Sixaxis9/GiordyBot_Electronics/Wiki_Img/Communication.PNG

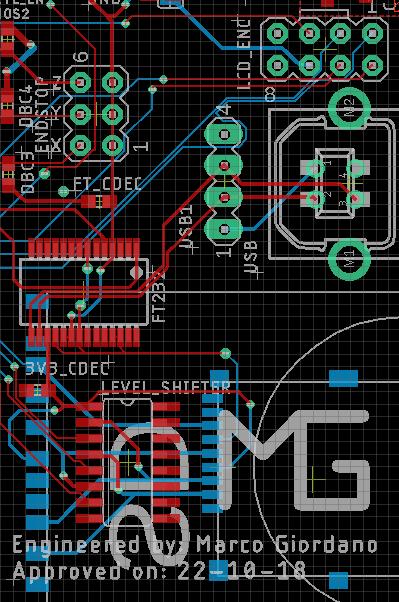
Wiki_Img/Communication.PNG
