Sixaxis9/GiordyBot_Electronics/Wiki_Img/Driver_IC.PNG

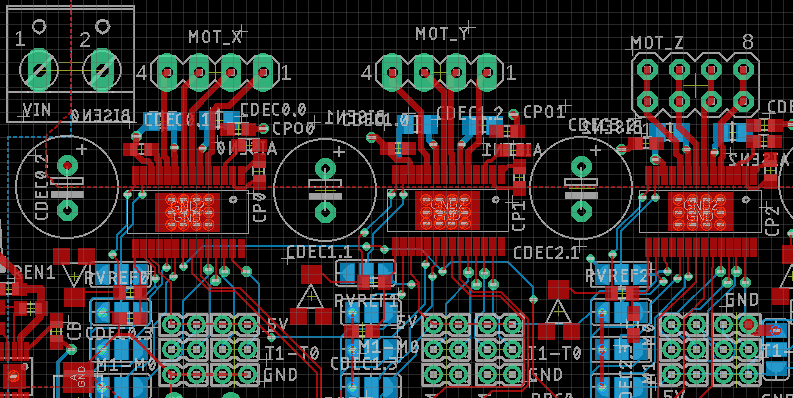
Wiki_Img/Driver_IC.PNG
