Sixaxis9/GiordyBot_Electronics/Wiki_Img/MOS.PNG

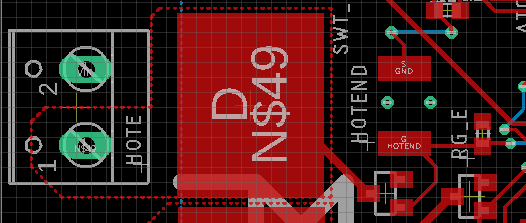
Wiki_Img/MOS.PNG
