Sixaxis9/GiordyBot_Electronics/Wiki_Img/PCB_Project.JPG

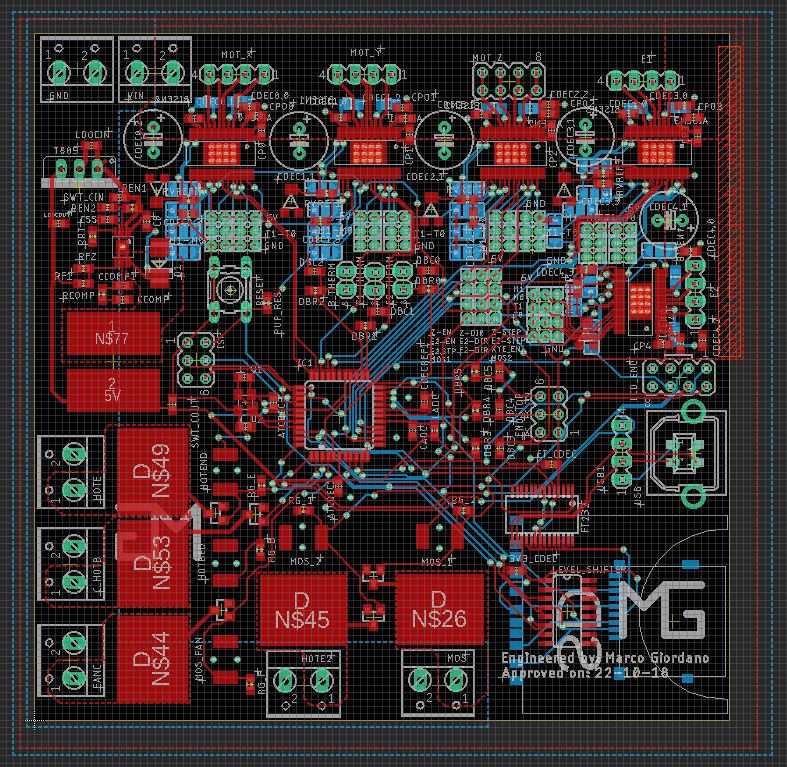
Wiki_Img/PCB_Project.JPG
