Sixaxis9/GiordyBot_Electronics/Wiki_Img/rsz_projects.jpg

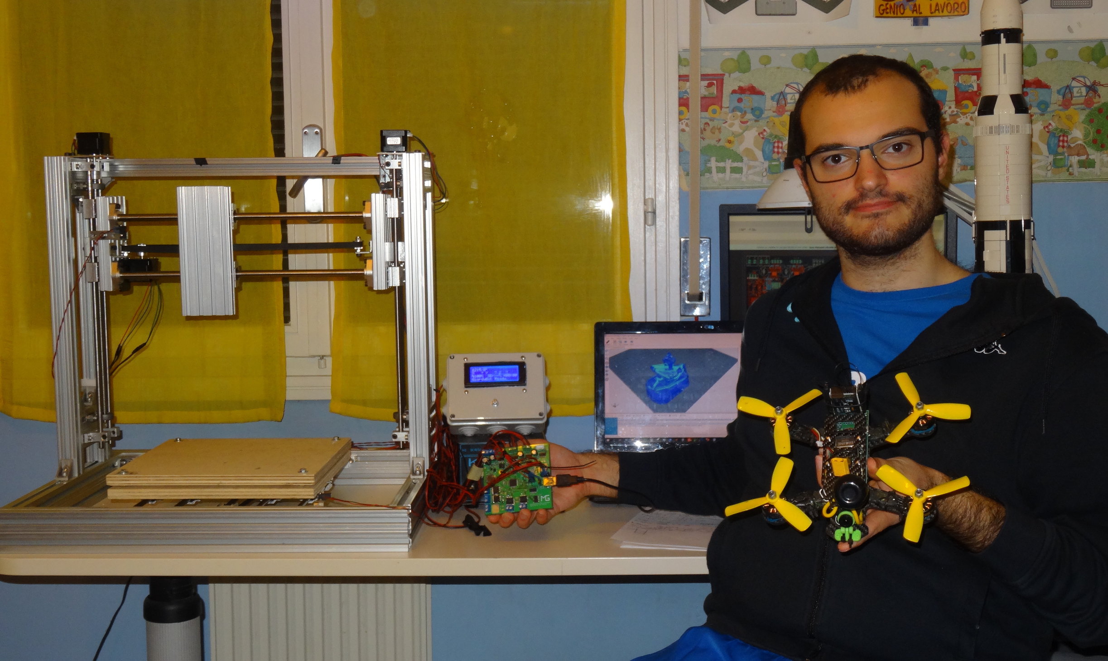
Wiki_Img/rsz_projects.jpg
