Sixaxis9/GiordyBot_Electronics/complete_schematic.pdf

# Y-DIR Y⁻STEP

# Y-STEP X⁻DIR

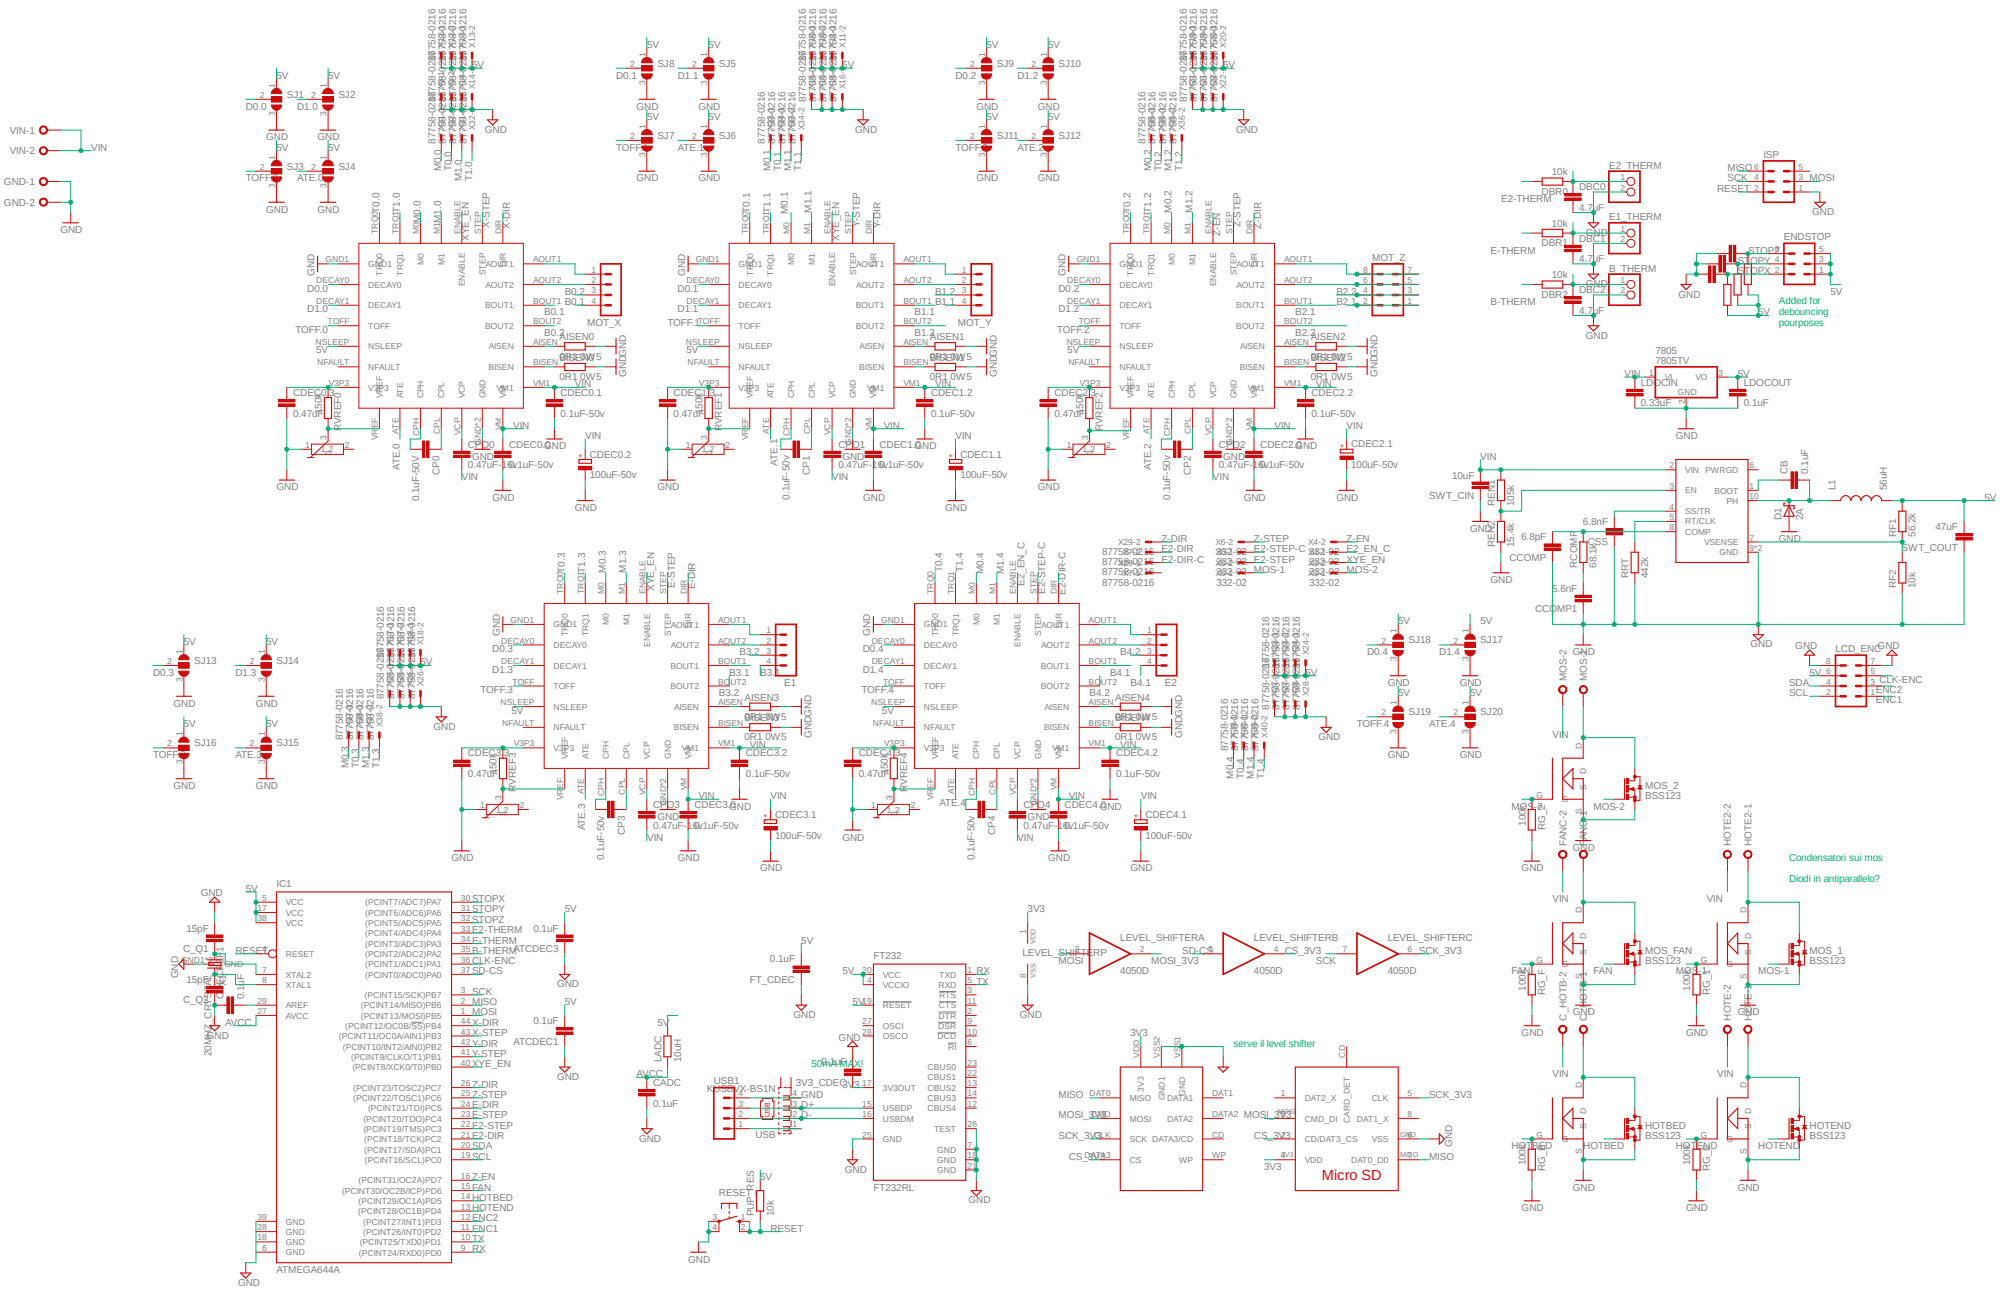
[picture p7: page 1]
KUSBVX-BS1N; GND; GND GND; 0R1 0W5 GND; GND ¹⁵⁰k; BSS123; GND ²⁰MHZ_CRYSTAL; 10k GND; GND 105k 15.4k; GND 100k 100k; ATMEGA644A; GND ⁰.1uF; GND1 GND1; DECAY0 DECAY0; DECAY1 DECAY1; TOFF TOFF; NSLEEP NSLEEP; NFAULT NFAULT; VREF VREF; ATE ATE; CPH CPH; CPL CPL; VCP VCP; GND GND*2; BISEN; AISEN; BOUT2; BOUT1; AOUT2; AOUT1; AOUT1 DIR DIR STEP STEP ENABLE ENABLE M¹ M¹ M⁰ M⁰ TRQ¹ TRQ¹ TRQ⁰ TRQ⁰; VCC 20; 3V3OUT 17; USBDP 15 USBDM 16; OSCO 28; OSCI 27; TXD; RXD; RTS; CTS; DTR; DSR; DCD; CBUS0; CBUS1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

Condensatori sui mos

Diodi in antiparallelo?

serve il level shifter

GND 18 | TX
GND 6 | RX
