Sixaxis9/GiordyBot_Electronics/CNC.brd

## EAGLE design CNC.brd (2019-01-07)

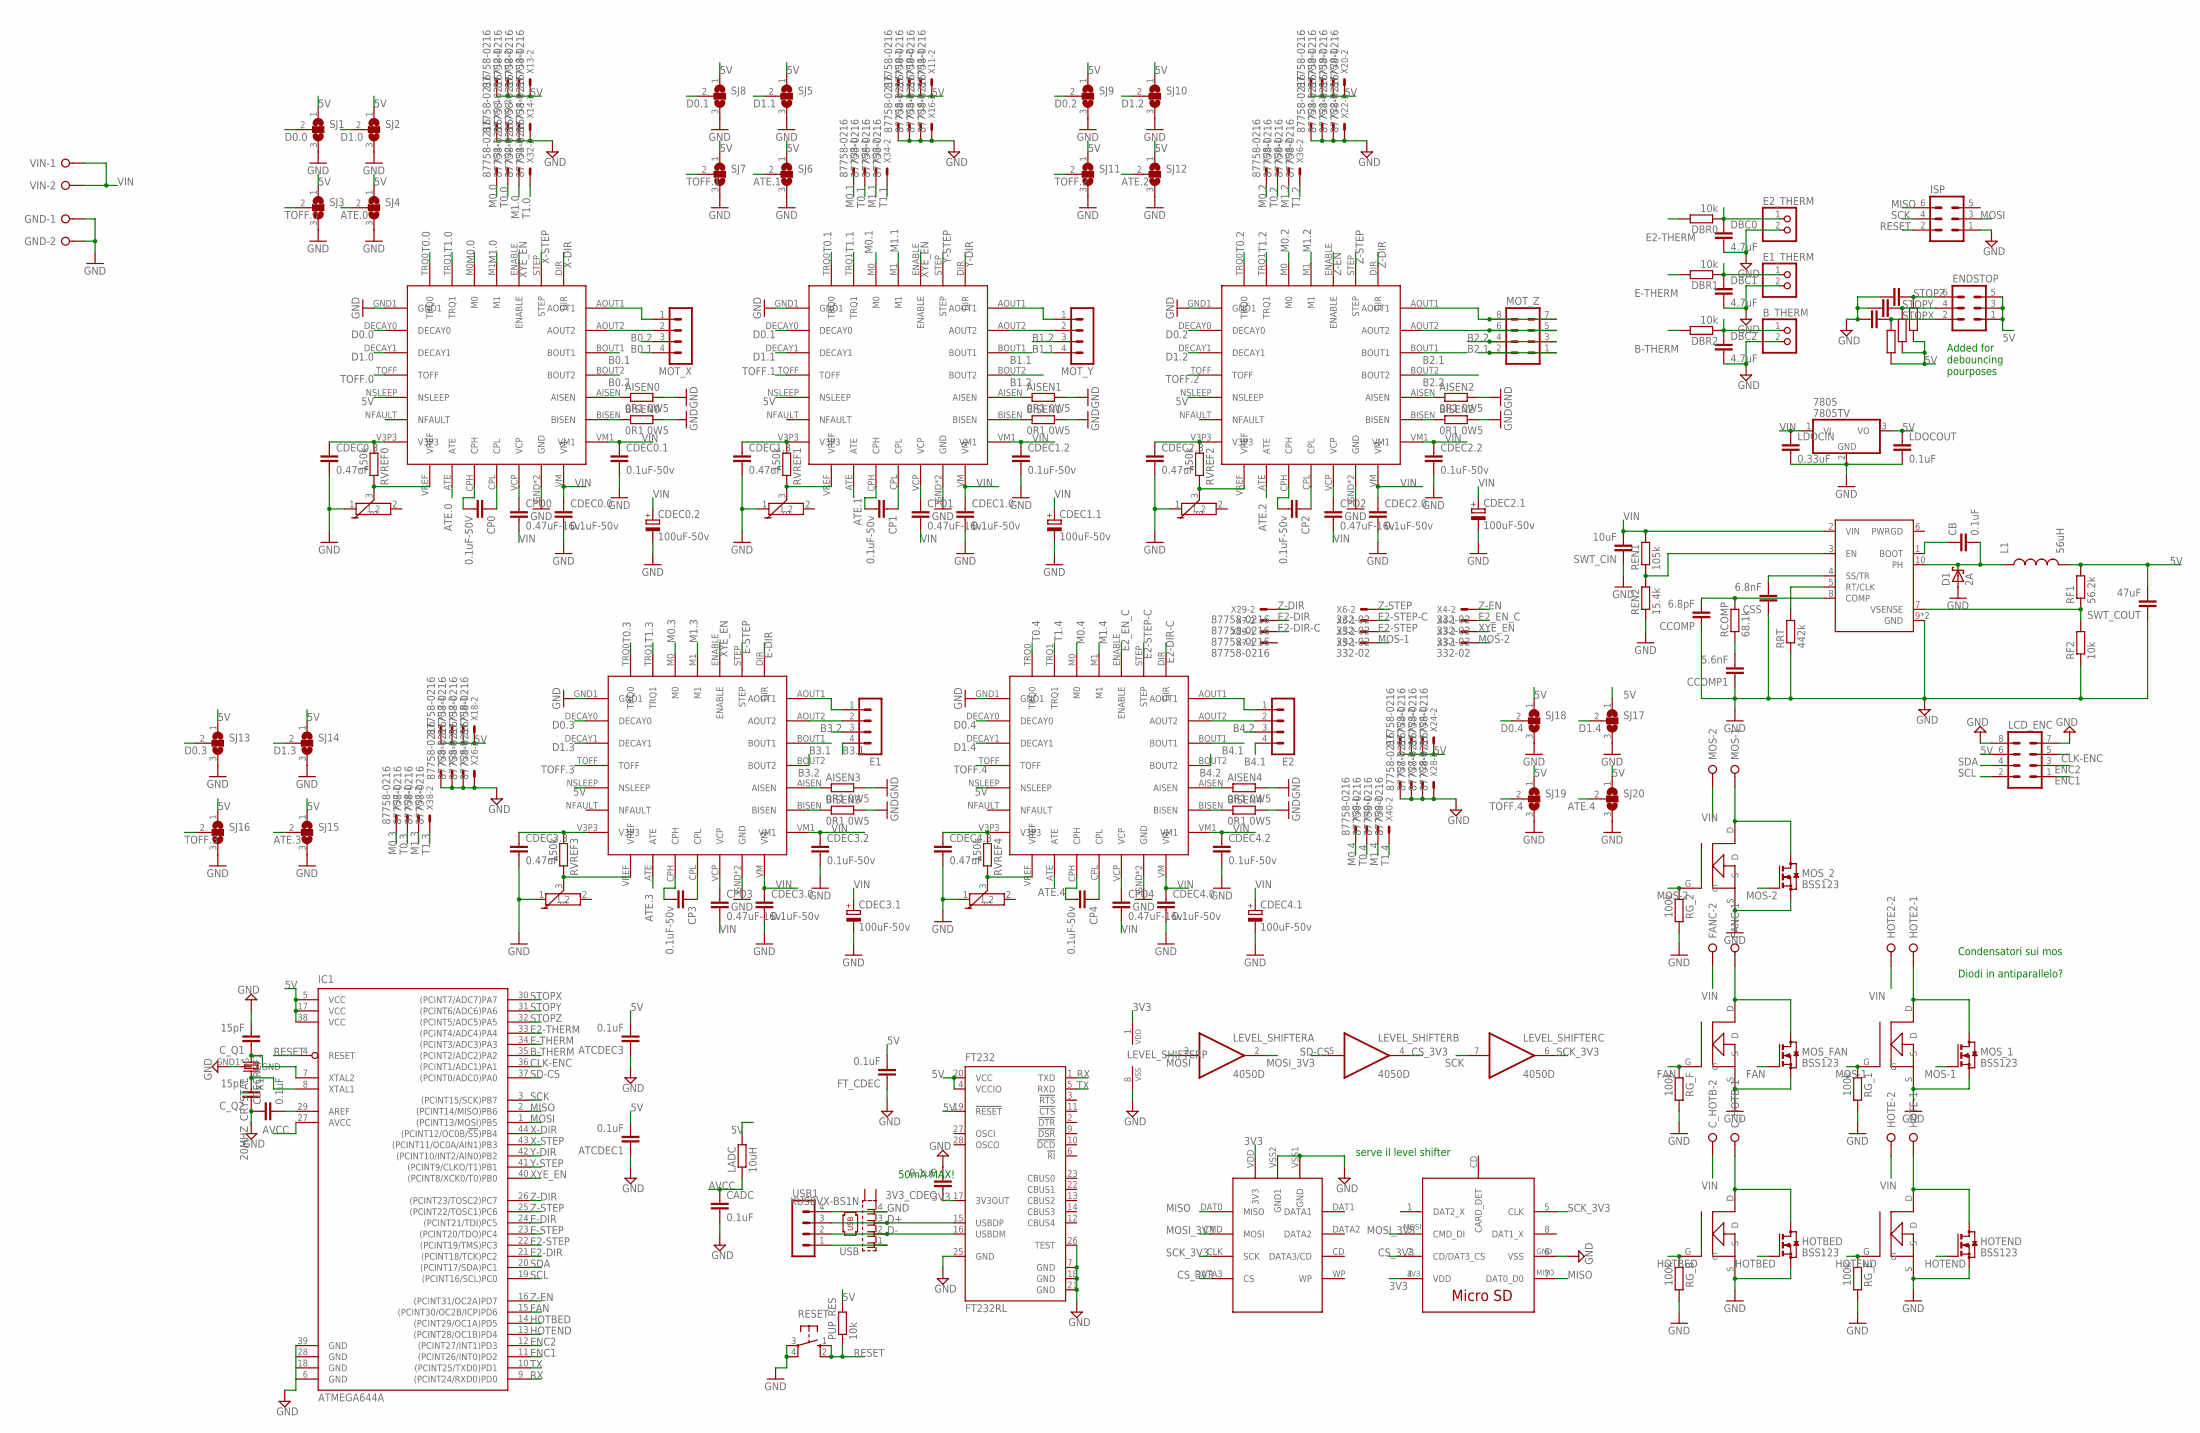
[picture p8: schematic CNC.sch]

Parts:
3V3_CDEC: 0.1uF; C0603
7805: 7805TV; TO220V
AISEN0, AISEN1, AISEN2, AISEN3, AISEN4: 0R1 0W5; R0805
ATCDEC1, ATCDEC3: 0.1uF; C0603
BISEN0, BISEN1, BISEN2, BISEN3, BISEN4: 0R1 0W5; R0805
B_THERM: PINHD-1X2; 1X02
CADC: 0.1uF; C0603
CB: 0.1uF; C0603
CCOMP: 6.8pF; C0603
CCOMP1: 5.6nF; C0603
CDEC0.0, CDEC0.1, CDEC1.0, CDEC1.2, CDEC2.0, CDEC2.2, CDEC3.0, CDEC3.2, CDEC4.0, CDEC4.2: 0.1uF-50v; C0603
CDEC0.2, CDEC1.1, CDEC2.1, CDEC3.1, CDEC4.1: 100uF-50v; E3,5-8
CDEC0.3, CDEC1.3, CDEC2.3, CDEC3.3, CDEC4.3: 0.47uF; C0603
CDECREF1: 0.1uF; C0603
CP0: 0.1uF-50V; C0603
CP1, CP2, CP3, CP4: 0.1uF-50v; C0603
CPO0, CPO1, CPO2, CPO3, CPO4: 0.47uF-16v; C0603
CSS: 6.8nF; C0603
C_HOTB: W237-02P; W237-132
C_Q1, C_Q2: 15pF; C0603
D1: 2A; SMB
DBC0, DBC1, DBC2: 4.7uF; C0603
DBC3, DBC4, DBC5: 0.1uF; C0603
DBR0, DBR1, DBR2, DBR3, DBR4, DBR5: 10k; R0603
E1, E2: MA04-1
E1_THERM, E2_THERM: PINHD-1X2; 1X02
ENDSTOP: MA03-2
EXT_1, EXT_2: DRV8880; HTSSOP
FANC: W237-02P; W237-132
FT232: FT232RL; SSOP28
FT_CDEC: 0.1uF; C0603
GND: W237-02P; W237-132
HOTBED: BSS123; SOT23
HOTBED1: POWER_MOSFET; D2PAK
HOTE, HOTE2: W237-02P; W237-132
HOTEND: BSS123; SOT23
HOTEND1: POWER_MOSFET; D2PAK
IC1: ATMEGA644A; TQFP44
ISP: MA03-2
L1: 56uH; INDUCTOR
LADC: 10uH; R0603
LCD_ENC: MA04-2
LDOCIN: 0.33uF; C0603
LDOCOUT: 0.1uF; C0603
LEVEL_SHIFTER: 4050D; SO16
MOS: W237-02P; W237-132
MOS11, MOS22: POWER_MOSFET; D2PAK
MOS_1, MOS_2: BSS123; SOT23
MOS_FAN: BSS123; SOT23
MOS_FAN1: POWER_MOSFET; D2PAK
MOT_X: MA04-1
MOT_Y: MA04-1
MOT_Z: MA04-2
PUP_RES: 10k; R0603
RCOMP: 68.1k; R0603
REN1: 105k; R0603
REN2: 15.4k; R0603
RESET: 10-XX; B3F-10XX
RF1: 56.2k; R0603
RF2: 10k; R0603
RG_1, RG_2: 100k; R0603
RG_B: 100k; R0603
RG_E: 100k; R0603
RG_F: 100k; R0603
RRT: 442k; R0603
RVREF0, RVREF1, RVREF2, RVREF3, RVREF4: 150k; R0603
SD: SD_CARD
SJ1, SJ2, SJ3, SJ4, SJ5, SJ6, SJ7, SJ8, SJ9, SJ10, SJ11, SJ12, SJ13, SJ14, SJ15, SJ16, SJ17, SJ18, SJ19, SJ20: SJ2W; SJ_2
SUPPLY: TPS54160; MSOP
SWT_CIN: 10uF; C0603
SWT_COUT: 47uF; C0603
T0: 100k; TRIMMER
T1, T2, T3, T4: TRIMMER
USB: KUSBVX-BS1N
USB1: MA04-1
USD: MICRO-SD
VIN: W237-02P; W237-132
X1: 20MHZ_CRYSTAL; SMD-3225_4P
X3, X4, X5, X6: 332-02
X7, X9, X10, X11, X12, X13, X14, X15, X16, X17, X18, X19, X20, X21, X22, X23, X24, X25, X26, X27, X28, X29, X31, X32, X33, X34, X35, X36, X37, X38, X39, X40: 87758-0216
X_AXIS: DRV8880; HTSSOP
Y-AXIS: DRV8880; HTSSOP
Z_AXIS: DRV8880; HTSSOP

Connections:
3V3: 3V3_CDEC.1, FT232.17 (3V3OUT), LEVEL_SHIFTER.1 (VDD), SD.VDD (3V3), USD.4 (VDD)
5V: 7805.3 (VO), ATCDEC1.2, ATCDEC3.2, DBR3.2, DBR4.2, DBR5.2, ENDSTOP.1, ENDSTOP.3, ENDSTOP.5, EXT_1.NSLEEP, EXT_2.NSLEEP, FT232.4 (VCCIO), FT232.19 (!RESET), FT232.20 (VCC), FT_CDEC.2, IC1.5 (VCC), IC1.17 (VCC), IC1.38 (VCC), L1.2, LADC.2, LCD_ENC.6, LDOCOUT.1, PUP_RES.2, RF1.2, SJ1.1, SJ2.1, SJ3.1, SJ4.1, SJ5.1, SJ6.1, SJ7.1, SJ8.1, SJ9.1, SJ10.1, SJ11.1, SJ12.1, SJ13.1, SJ14.1, SJ15.1, SJ16.1, SJ17.1, SJ18.1, SJ19.1, SJ20.1, SWT_COUT.2, X10.1, X10.2, X11.1, X11.2, X12.1, X12.2, X13.1, X13.2, X17.1, X17.2, X18.1, X18.2, X19.1, X19.2, X20.1, X20.2, X23.1, X23.2, X24.1, X24.2, X_AXIS.NSLEEP, Y-AXIS.NSLEEP, Z_AXIS.NSLEEP
ATE.0: SJ4.2, X_AXIS.ATE
ATE.1: SJ6.2, Y-AXIS.ATE
ATE.2: SJ12.2, Z_AXIS.ATE
ATE.3: EXT_1.ATE, SJ15.2
ATE.4: EXT_2.ATE, SJ20.2
AVCC: CADC.1, IC1.27 (AVCC), LADC.1
B0.1: MOT_X.4, X_AXIS.BOUT1
B0.2: MOT_X.3, X_AXIS.BOUT2
B1.1: MOT_Y.4, Y-AXIS.BOUT1
B1.2: MOT_Y.3, Y-AXIS.BOUT2
B2.1: MOT_Z.1, MOT_Z.2, Z_AXIS.BOUT1
B2.2: MOT_Z.3, MOT_Z.4, Z_AXIS.BOUT2
B3.1: E1.4, EXT_1.BOUT1
B3.2: E1.3, EXT_1.BOUT2
B4.1: E2.4, EXT_2.BOUT1
B4.2: E2.3, EXT_2.BOUT2
B-THERM: DBR2.2, IC1.35 ((PCINT2/ADC2)PA2)
CLK-ENC: IC1.36 ((PCINT1/ADC1)PA1), LCD_ENC.5
CS_3V3: LEVEL_SHIFTER.4 (O), SD.DATA3 (CS), USD.2 (CD/DAT3_CS)
D0.0: SJ1.2, X_AXIS.DECAY0
D0.1: SJ8.2, Y-AXIS.DECAY0
D0.2: SJ9.2, Z_AXIS.DECAY0
D0.3: EXT_1.DECAY0, SJ13.2
D0.4: EXT_2.DECAY0, SJ18.2
D1.0: SJ2.2, X_AXIS.DECAY1
D1.1: SJ5.2, Y-AXIS.DECAY1
D1.2: SJ10.2, Z_AXIS.DECAY1
D1.3: EXT_1.DECAY1, SJ14.2
D1.4: EXT_2.DECAY1, SJ17.2
D+: FT232.15 (USBDP), USB.3, USB1.3
D-: FT232.16 (USBDM), USB.2, USB1.2
E2-DIR: IC1.21 ((PCINT18/TCK)PC2), X7.2
E2-DIR-C: EXT_2.DIR, X29.1
E2-STEP: IC1.22 ((PCINT19/TMS)PC3), X5.2
E2-STEP-C: EXT_2.STEP, X6.1
E2-THERM: DBR0.2, IC1.33 ((PCINT4/ADC4)PA4)
E2_EN_C: EXT_2.ENABLE, X4.1
E-DIR: EXT_1.DIR, IC1.24 ((PCINT21/TDI)PC5)
E-STEP: EXT_1.STEP, IC1.23 ((PCINT20/TDO)PC4)
E-THERM: DBR1.2, IC1.34 ((PCINT3/ADC3)PA3)
ENC1: IC1.11 ((PCINT26/INT0)PD2), LCD_ENC.1
ENC2: IC1.12 ((PCINT27/INT1)PD3), LCD_ENC.3
FAN: IC1.15 ((PCINT30/OC2B/ICP)PD6), MOS_FAN.1 (G), MOS_FAN1.G, RG_F.1
GND: 3V3_CDEC.2, 7805.2 (GND), AISEN0.2, AISEN1.2, AISEN2.2, AISEN3.2, AISEN4.2, ATCDEC1.1, ATCDEC3.1, BISEN0.2, BISEN1.2, BISEN2.2, BISEN3.2, BISEN4.2, B_THERM.2, CADC.2, CCOMP.1, CCOMP1.1, CDEC0.0.2, CDEC0.1.2, CDEC0.2.-, CDEC0.3.2, CDEC1.0.2, CDEC1.1.-, CDEC1.2.2, CDEC1.3.2, CDEC2.0.2, CDEC2.1.-, CDEC2.2.2, CDEC2.3.2, CDEC3.0.2, CDEC3.1.-, CDEC3.2.2, CDEC3.3.2, CDEC4.0.2, CDEC4.1.-, CDEC4.2.2, CDEC4.3.2, CDECREF1.1, CSS.1, C_Q1.2, C_Q2.1, D1.A, DBC0.2, DBC1.2, DBC2.2, DBC3.2, DBC4.2, DBC5.2, E1_THERM.2, E2_THERM.2, EXT_1.GND, EXT_1.GND1, EXT_1.GND2 (GND), EXT_2.GND, EXT_2.GND1, EXT_2.GND2 (GND), FT232.7 (GND), FT232.18 (GND), FT232.21 (GND), FT232.25 (GND), FT232.26 (TEST), FT_CDEC.1, GND.1, GND.2, HOTBED.2 (S), HOTBED1.S, HOTEND.2 (S), HOTEND1.S, IC1.6 (GND), IC1.18 (GND), IC1.28 (GND), IC1.39 (GND), ISP.1, LCD_ENC.7, LCD_ENC.8, LDOCIN.2, LDOCOUT.2, LEVEL_SHIFTER.8 (VSS), MOS11.S, MOS22.S, MOS_1.2 (S), MOS_2.2 (S), MOS_FAN.2 (S), MOS_FAN1.S, REN2.1, RESET.3, RESET.4 (P1), RF2.1, RG_1.2, RG_2.2, RG_B.2, RG_E.2, RG_F.2, RRT.1, SD.VSS1 (GND), SD.VSS2 (GND1), SJ1.3, SJ2.3, SJ3.3, SJ4.3, SJ5.3, SJ6.3, SJ7.3, SJ8.3, SJ9.3, SJ10.3, SJ11.3, SJ12.3, SJ13.3, SJ14.3, SJ15.3, SJ16.3, SJ17.3, SJ18.3, SJ19.3, SJ20.3, SUPPLY.9 (GND), SUPPLY.GND, SWT_CIN.1, SWT_COUT.1, T0.1, T1.1, T2.1, T3.1, T4.1, USB.4, USB1.4, USD.6 (VSS), X1.GND1 (GND), X1.GND2 (GND), X9.1, X9.2, X14.1, X14.2, X15.1, X15.2, X16.1, X16.2, X21.1, X21.2, X22.1, X22.2, X25.1, X25.2, X26.1, X26.2, X27.1, X27.2, X28.1, X28.2, X_AXIS.GND, X_AXIS.GND1, X_AXIS.GND2 (GND), Y-AXIS.GND, Y-AXIS.GND1, Y-AXIS.GND2 (GND), Z_AXIS.GND, Z_AXIS.GND1, Z_AXIS.GND2 (GND)
HOTBED: HOTBED.1 (G), HOTBED1.G, IC1.14 ((PCINT29/OC1A)PD5), RG_B.1
HOTEND: HOTEND.1 (G), HOTEND1.G, IC1.13 ((PCINT28/OC1B)PD4), RG_E.1
M0.0: X31.1, X_AXIS.M0
M0.1: X33.1, Y-AXIS.M0
M0.2: X35.1, Z_AXIS.M0
M0.3: EXT_1.M0, X37.1
M0.4: EXT_2.M0, X39.1
M1.0: X31.2, X_AXIS.M1
M1.1: X33.2, Y-AXIS.M1
M1.2: X35.2, Z_AXIS.M1
M1.3: EXT_1.M1, X37.2
M1.4: EXT_2.M1, X39.2
MISO: IC1.2 ((PCINT14/MISO)PB6), ISP.6, SD.DAT0 (MISO), USD.7 (DAT0_D0)
MOS-1: MOS11.G, MOS_1.1 (G), RG_1.1, X5.1
MOS-2: MOS22.G, MOS_2.1 (G), RG_2.1, X3.1
MOSI: IC1.1 ((PCINT13/MOSI)PB5), ISP.3, LEVEL_SHIFTER.3 (I)
MOSI_3V3: LEVEL_SHIFTER.2 (O), SD.CMD (MOSI), USD.3 (CMD_DI)
unnamed: DBC1.1, DBR1.1, E1_THERM.1
unnamed: DBC0.1, DBR0.1, E2_THERM.1
unnamed: REN1.1, REN2.2, SUPPLY.3 (EN)
unnamed: USB.1, USB1.1
unnamed: MOT_Y.1, Y-AXIS.AOUT1
unnamed: MOT_Y.2, Y-AXIS.AOUT2
unnamed: MOT_X.1, X_AXIS.AOUT1
unnamed: MOT_X.2, X_AXIS.AOUT2
unnamed: MOT_Z.7, MOT_Z.8, Z_AXIS.AOUT1
unnamed: MOT_Z.5, MOT_Z.6, Z_AXIS.AOUT2
unnamed: E1.1, EXT_1.AOUT1
unnamed: E1.2, EXT_1.AOUT2
unnamed: E2.2, EXT_2.AOUT2
unnamed: E2.1, EXT_2.AOUT1
unnamed: RRT.2, SUPPLY.5 (RT/CLK)
unnamed: MOS.1, MOS22.D, MOS_2.3 (D)
unnamed: CDEC0.3.1, RVREF0.1, X_AXIS.V3P3
unnamed: CDEC1.3.1, RVREF1.1, Y-AXIS.V3P3
unnamed: CPO4.1, EXT_2.VCP
unnamed: CP4.1, EXT_2.CPL
unnamed: CP4.2, EXT_2.CPH
unnamed: CDEC2.3.1, RVREF2.1, Z_AXIS.V3P3
unnamed: CDEC4.3.1, EXT_2.V3P3, RVREF4.1
unnamed: CPO3.1, EXT_1.VCP
unnamed: CP3.1, EXT_1.CPL
unnamed: CP3.2, EXT_1.CPH
unnamed: CDEC3.3.1, EXT_1.V3P3, RVREF3.1
unnamed: CPO0.1, X_AXIS.VCP
unnamed: CP0.1, X_AXIS.CPL
unnamed: CP0.2, X_AXIS.CPH
unnamed: FANC.1, MOS_FAN.3 (D), MOS_FAN1.D
unnamed: HOTE2.1, MOS11.D, MOS_1.3 (D)
unnamed: CPO1.1, Y-AXIS.VCP
unnamed: CP1.1, Y-AXIS.CPL
unnamed: CP1.2, Y-AXIS.CPH
unnamed: HOTE.1, HOTEND.3 (D), HOTEND1.D
unnamed: CPO2.1, Z_AXIS.VCP
unnamed: CP2.1, Z_AXIS.CPL
unnamed: CP2.2, Z_AXIS.CPH
unnamed: C_HOTB.1, HOTBED.3 (D), HOTBED1.D
unnamed: C_Q1.1, IC1.7 (XTAL2), X1.X1
unnamed: C_Q2.2, IC1.8 (XTAL1), X1.X2
unnamed: CSS.2, SUPPLY.4 (SS/TR)
unnamed: CB.1, SUPPLY.1 (BOOT)
unnamed: CCOMP1.2, RCOMP.1
unnamed: AISEN1.1, Y-AXIS.AISEN
unnamed: BISEN1.1, Y-AXIS.BISEN
unnamed: AISEN2.1, Z_AXIS.AISEN
unnamed: BISEN2.1, Z_AXIS.BISEN
unnamed: AISEN3.1, EXT_1.AISEN
unnamed: BISEN3.1, EXT_1.BISEN
unnamed: AISEN4.1, EXT_2.AISEN
unnamed: BISEN4.1, EXT_2.BISEN
unnamed: AISEN0.1, X_AXIS.AISEN
unnamed: BISEN0.1, X_AXIS.BISEN
unnamed: EXT_2.VREF, RVREF4.2, T4.3
unnamed: EXT_1.VREF, RVREF3.2, T3.3
unnamed: RVREF0.2, T0.3, X_AXIS.VREF
unnamed: RVREF1.2, T1.3, Y-AXIS.VREF
unnamed: RVREF2.2, T2.3, Z_AXIS.VREF
unnamed: CCOMP.2, RCOMP.2, SUPPLY.8 (COMP)
unnamed: CDECREF1.2, IC1.29 (AREF)
unnamed: CB.2, D1.C, L1.1, SUPPLY.10 (PH)
unnamed: B_THERM.1, DBC2.1, DBR2.1
unnamed: RF1.1, RF2.2, SUPPLY.7 (VSENSE)
RESET: IC1.4 (RESET), ISP.2, PUP_RES.1, RESET.1 (S), RESET.2 (S1)
RX: FT232.1 (TXD), IC1.9 ((PCINT24/RXD0)PD0)
SCK: IC1.3 ((PCINT15/SCK)PB7), ISP.4, LEVEL_SHIFTER.7 (I)
SCK_3V3: LEVEL_SHIFTER.6 (O), SD.CLK (SCK), USD.5 (CLK)
SCL: IC1.19 ((PCINT16/SCL)PC0), LCD_ENC.2
SD-CS: IC1.37 ((PCINT0/ADC0)PA0), LEVEL_SHIFTER.5 (I)
SDA: IC1.20 ((PCINT17/SDA)PC1), LCD_ENC.4
STOPX: DBC3.1, DBR3.1, ENDSTOP.2, IC1.30 ((PCINT7/ADC7)PA7)
STOPY: DBC4.1, DBR4.1, ENDSTOP.4, IC1.31 ((PCINT6/ADC6)PA6)
STOPZ: DBC5.1, DBR5.1, ENDSTOP.6, IC1.32 ((PCINT5/ADC5)PA5)
T0.0: X32.1, X_AXIS.TRQ0
T0.1: X34.1, Y-AXIS.TRQ0
T0.2: X36.1, Z_AXIS.TRQ0
T0.3: EXT_1.TRQ0, X38.1
T0.4: EXT_2.TRQ0, X40.1
T1.0: X32.2, X_AXIS.TRQ1
T1.1: X34.2, Y-AXIS.TRQ1
T1.2: X36.2, Z_AXIS.TRQ1
T1.3: EXT_1.TRQ1, X38.2
T1.4: EXT_2.TRQ1, X40.2
TOFF.0: SJ3.2, X_AXIS.TOFF
TOFF.1: SJ7.2, Y-AXIS.TOFF
TOFF.2: SJ11.2, Z_AXIS.TOFF
TOFF.3: EXT_1.TOFF, SJ16.2
TOFF.4: EXT_2.TOFF, SJ19.2
TX: FT232.5 (RXD), IC1.10 ((PCINT25/TXD0)PD1)
VIN: 7805.1 (VI), CDEC0.0.1, CDEC0.1.1, CDEC0.2.+, CDEC1.0.1, CDEC1.1.+, CDEC1.2.1, CDEC2.0.1, CDEC2.1.+, CDEC2.2.1, CDEC3.0.1, CDEC3.1.+, CDEC3.2.1, CDEC4.0.1, CDEC4.1.+, CDEC4.2.1, CPO0.2, CPO1.2, CPO2.2, CPO3.2, CPO4.2, C_HOTB.2, EXT_1.VM, EXT_1.VM1, EXT_2.VM, EXT_2.VM1, FANC.2, HOTE.2, HOTE2.2, LDOCIN.1, MOS.2, REN1.2, SUPPLY.2 (VIN), SWT_CIN.2, VIN.1, VIN.2, X_AXIS.VM, X_AXIS.VM1, Y-AXIS.VM, Y-AXIS.VM1, Z_AXIS.VM, Z_AXIS.VM1
X-DIR: IC1.44 ((PCINT12/OC0B/!SS!)PB4), X_AXIS.DIR
X-STEP: IC1.43 ((PCINT11/OC0A/AIN1)PB3), X_AXIS.STEP
XYE_EN: EXT_1.ENABLE, IC1.40 ((PCINT8/XCK0/T0)PB0), X3.2, X_AXIS.ENABLE, Y-AXIS.ENABLE
Y-DIR: IC1.42 ((PCINT10/INT2/AIN0)PB2), Y-AXIS.DIR
Y-STEP: IC1.41 ((PCINT9/CLKO/T1)PB1), Y-AXIS.STEP
Z-DIR: IC1.26 ((PCINT23/TOSC2)PC7), X29.2, Z_AXIS.DIR
Z-EN: IC1.16 ((PCINT31/OC2A)PD7), X4.2, Z_AXIS.ENABLE
Z-STEP: IC1.25 ((PCINT22/TOSC1)PC6), X6.2, Z_AXIS.STEP

Notes on the sheet:
serve il level shifter
50mA MAX!
Added for debouncing pourposes
Condensatori sui mos
Diodi in antiparallelo?

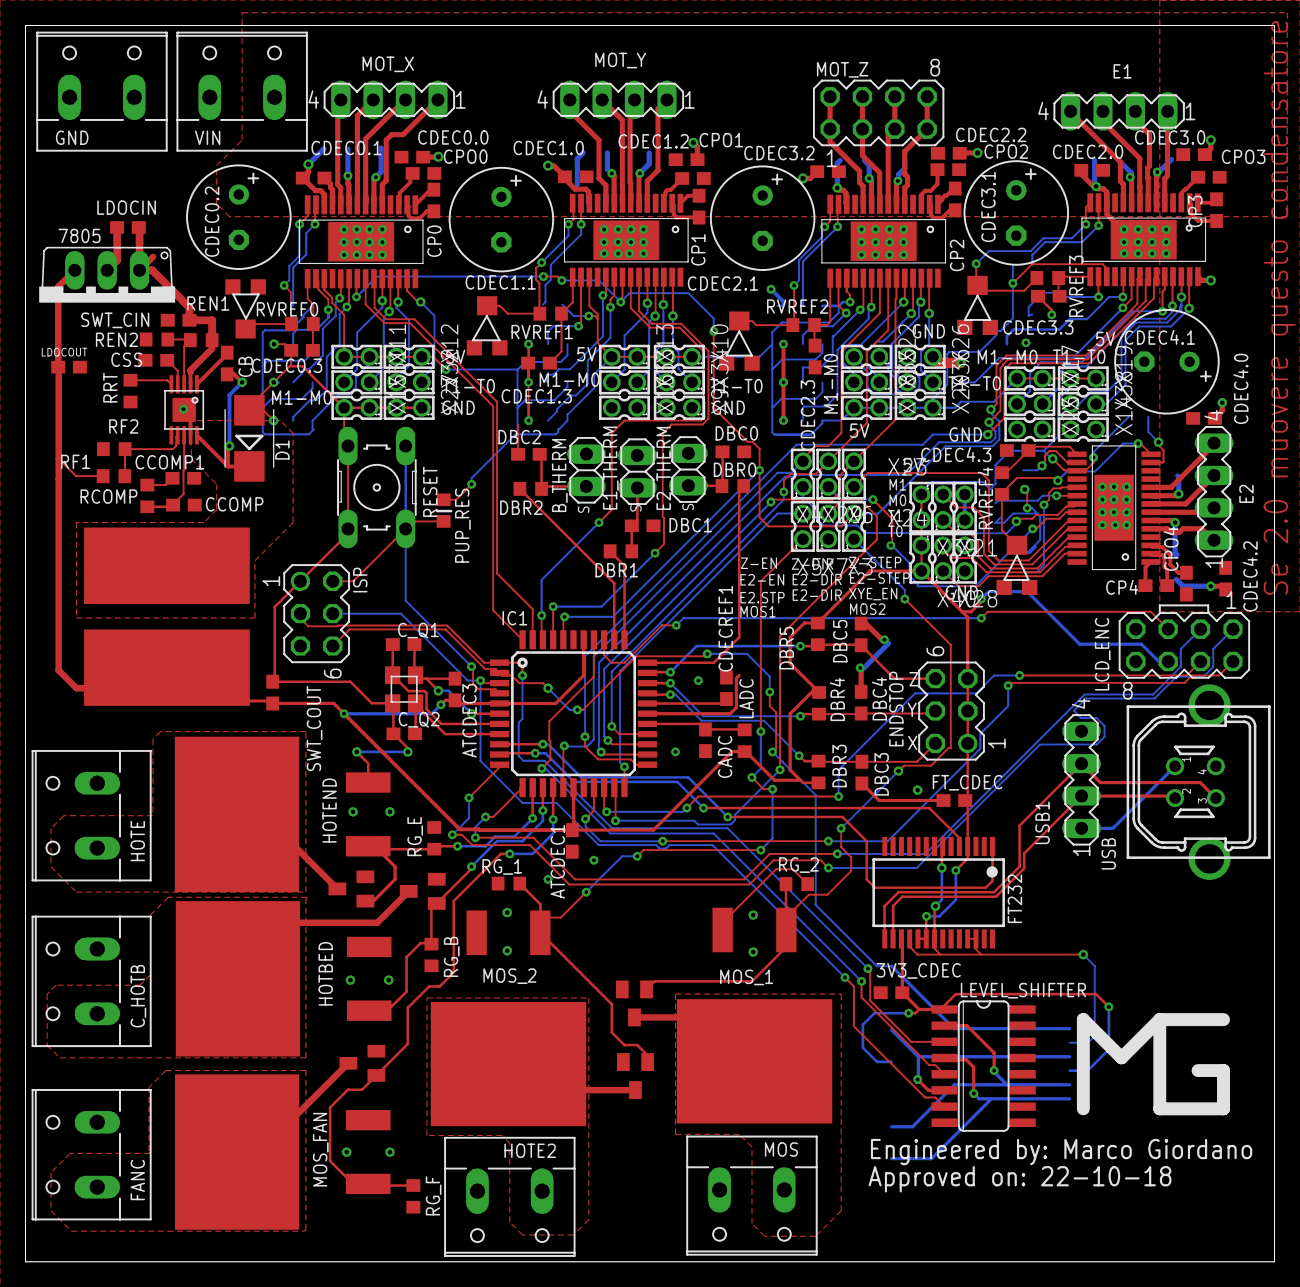
[picture p9: board CNC.brd from above]

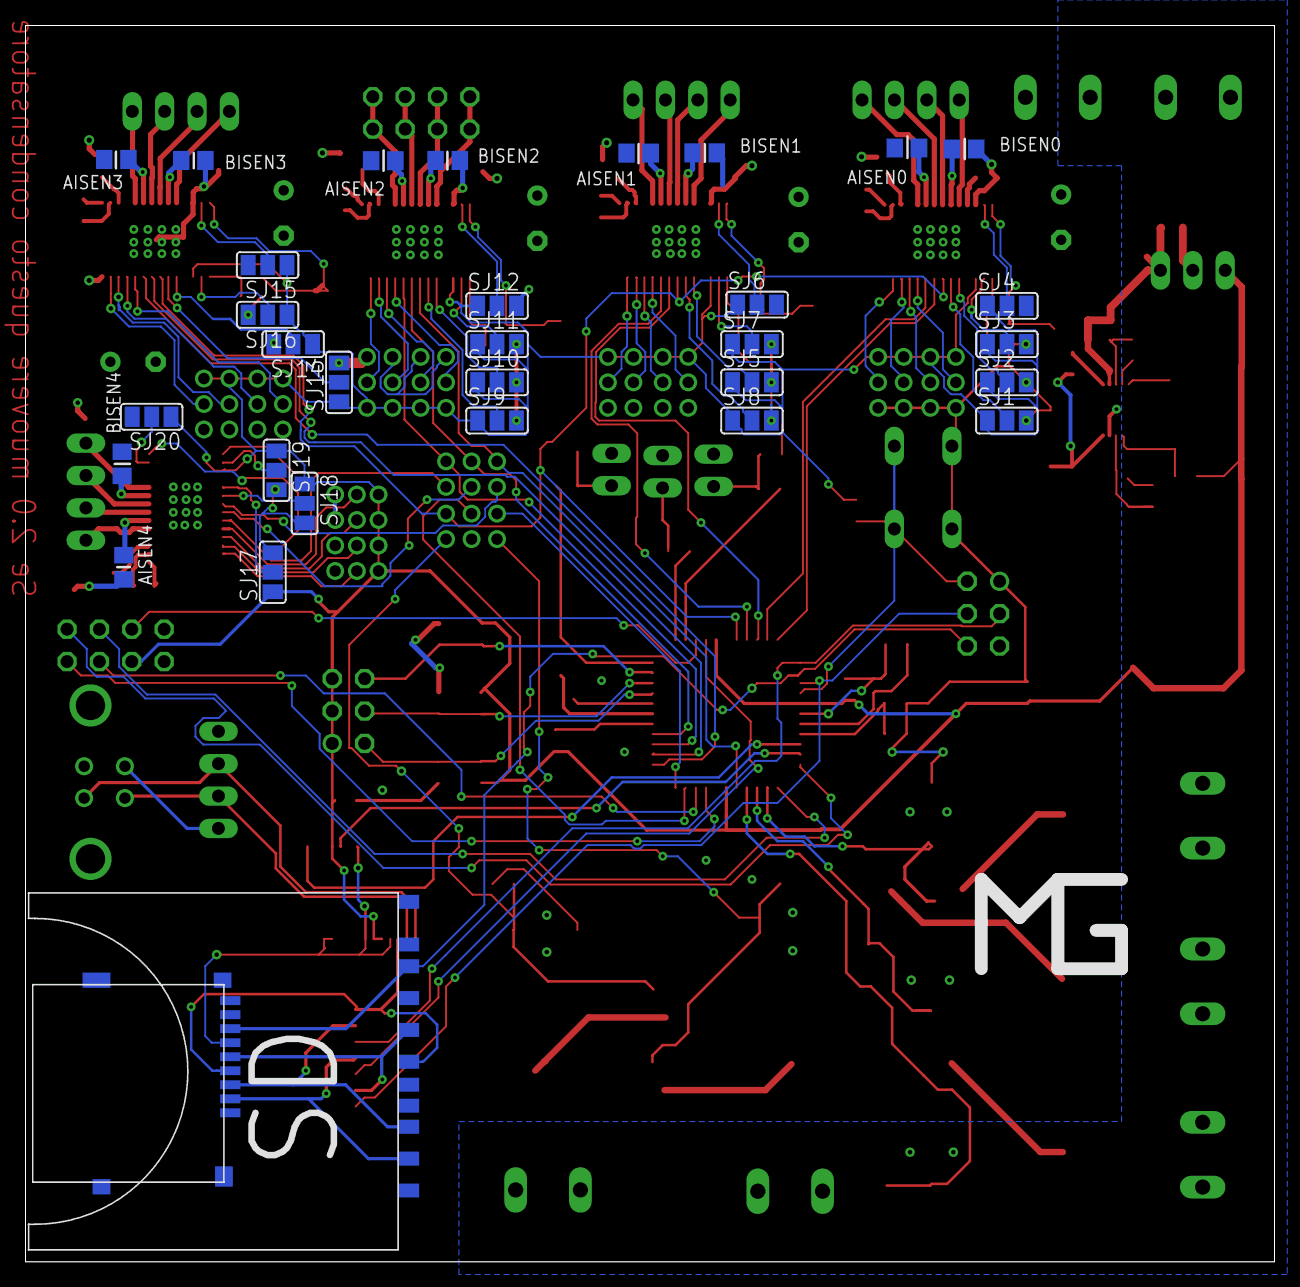
[picture p10: board CNC.brd from below]

Board: 2 copper layers, 98.0 x 97.0 mm, 193 parts (32 on the bottom side), 163 nets.
