Sixaxis9/GiordyBot_Electronics/Wiki_Img/Soldered_PCB.jpg

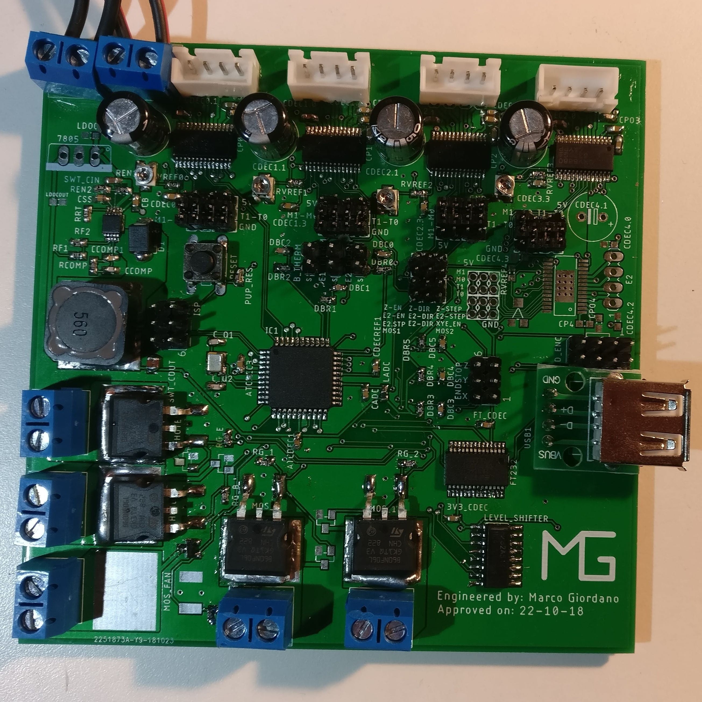
Wiki_Img/Soldered_PCB.jpg
