Sixaxis9/GiordyBot_Electronics/(commit log)

2019-01-07 Last version of PCB of my CNC&3D printer
    Last version of PCB of my CNC&3D printer is available! Huge modifications from previus versions, including a brand new stpper driver IC, provided by Texas Instruments DRV8880, with some amazin auto-tune functionalities. Power delivery has been bettered, with dual supply for motors and tools. The board is also almost all SMD to increase efficiency and dimensional optimization.
    [CNC.brd, CNC.sch]
2019-03-16 Modified PCB project picture
    Added a two pic side by side comparison
